zanylane/Swarm-Soccer-Robot/main_board_schematic.pdf

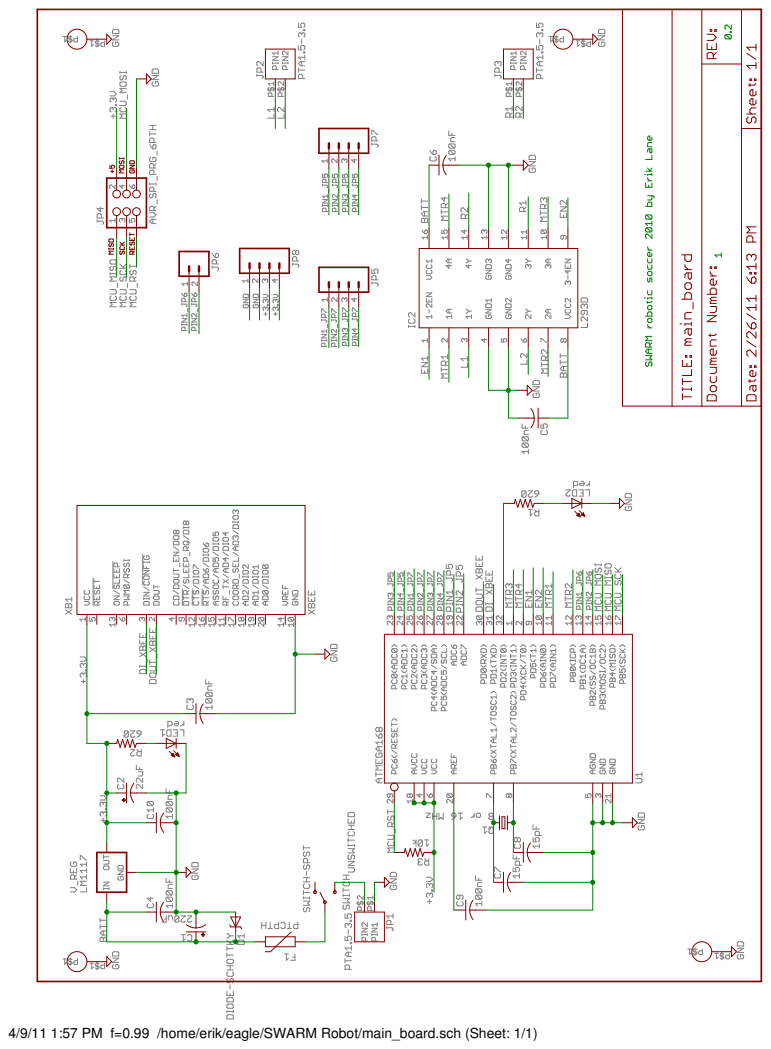
[picture p6: page 1]

4/9/11 1:57 PM f=0.99 /home/erik/eagle/SWARM Robot/main_board.sch (Sheet: 1/1)
